Entropyqwe/An-intelligent-following-car-vision-solution-based-on-Orange-Pi-and-STM32/03_接线参考/原图标注修改_单电机_20261029.png

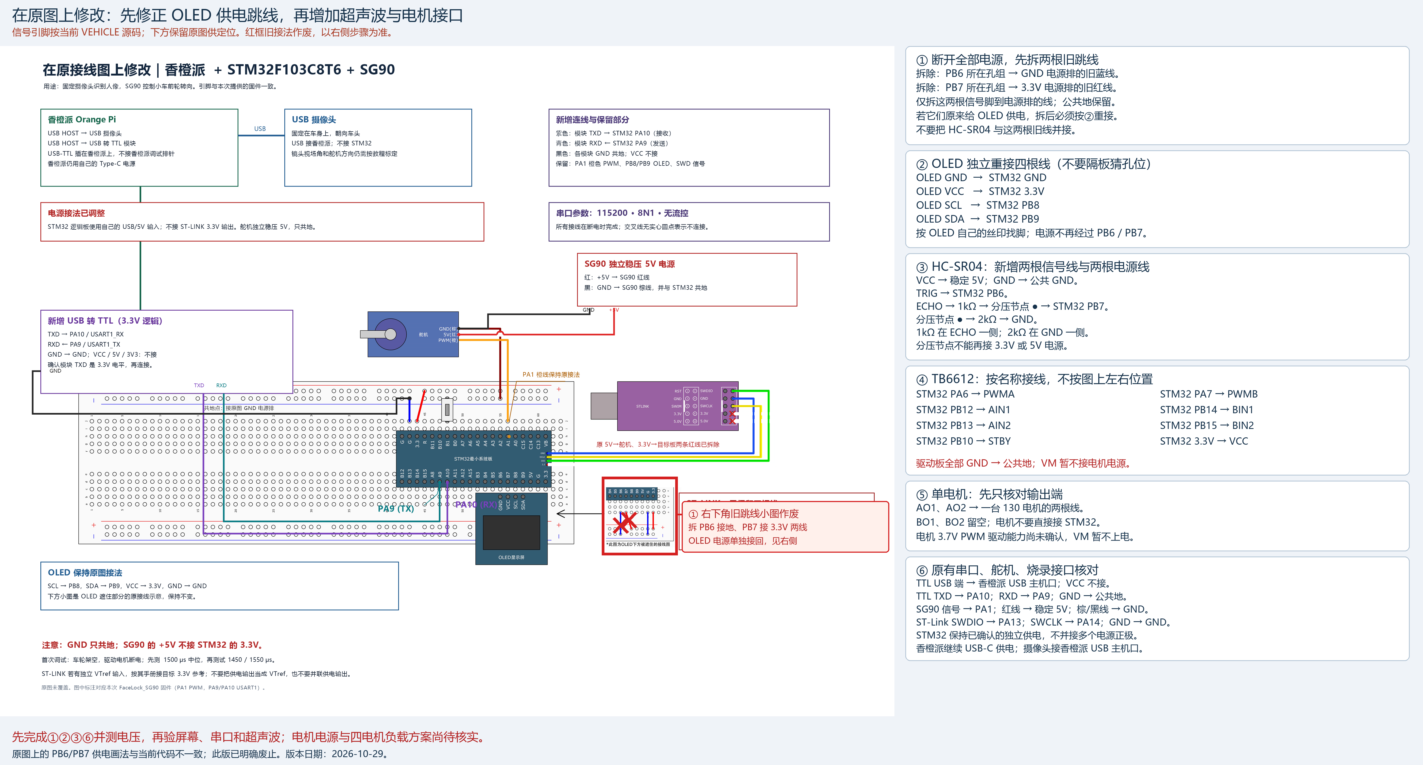
03_接线参考/原图标注修改_单电机_20261029.png
