Entropyqwe/An-intelligent-following-car-vision-solution-based-on-Orange-Pi-and-STM32/03_接线参考/逐线核对_单电机_20261029.png

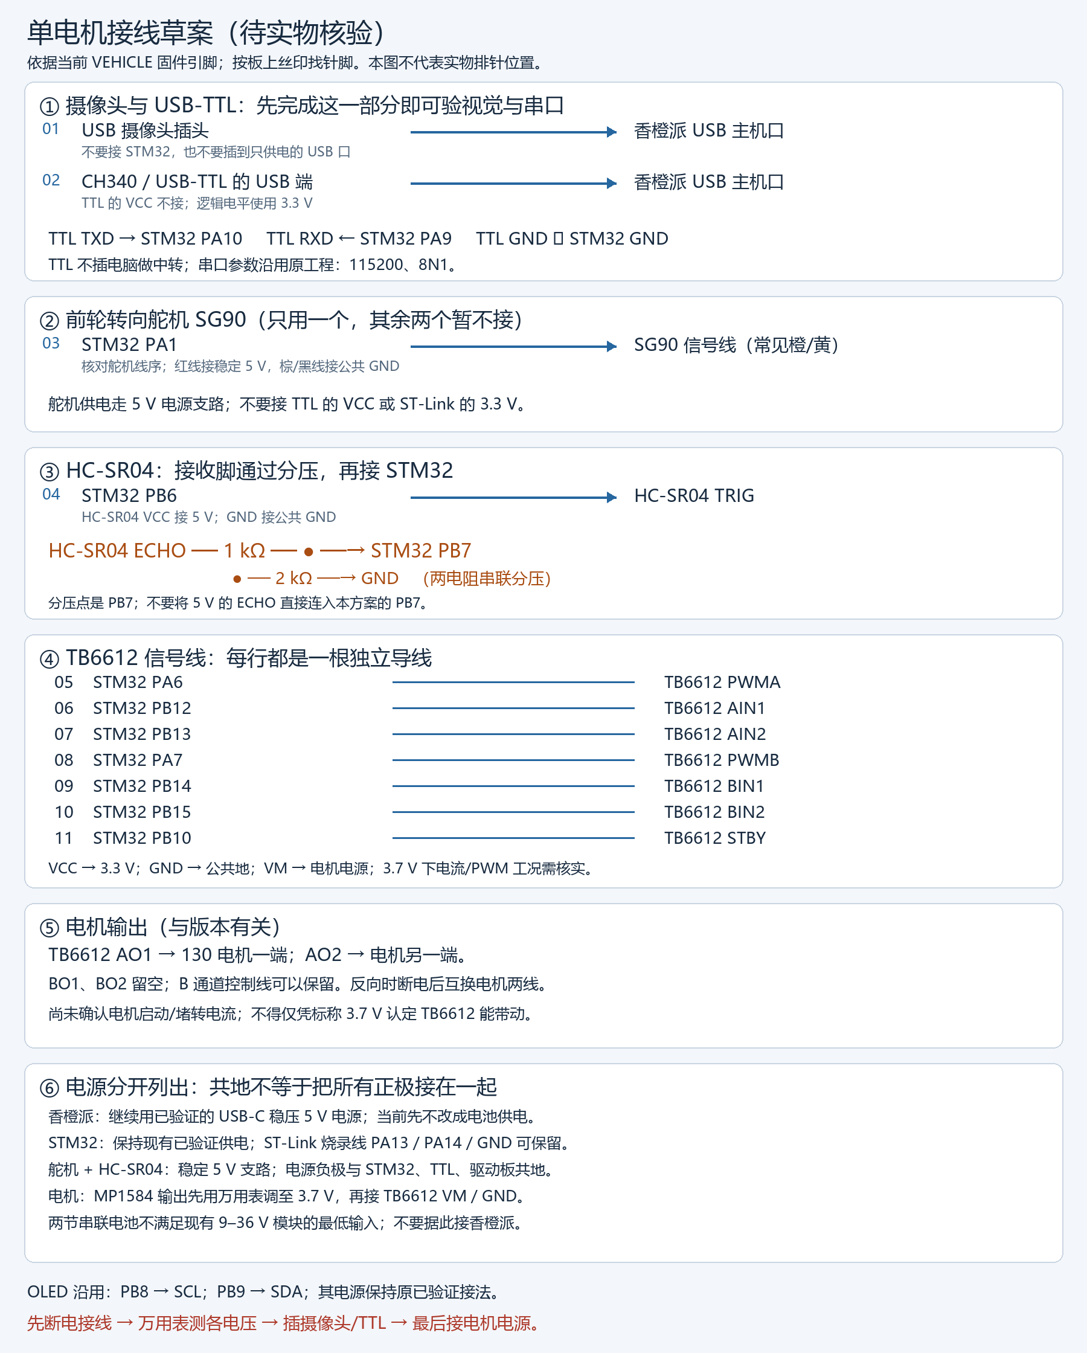
03_接线参考/逐线核对_单电机_20261029.png
