Entropyqwe/An-intelligent-following-car-vision-solution-based-on-Orange-Pi-and-STM32/windows运行/FaceLockCar_Windows/docs/validation_480p/tests_balanced.txt

..................Camera actual resolution: 1280x720; reported FPS: 60.0 (measure actual FPS separately)
........@S1,1,0,0,0,1500,999999,0*7B
@S1,2,1,1,16102,1550,100,2*4A
@S1,3,1,1,16102,1595,200,2*41
@S1,4,0,1,0,1500,999999,0*7F
........
----------------------------------------------------------------------
Ran 34 tests in 0.691s

OK
