Entropyqwe/An-intelligent-following-car-vision-solution-based-on-Orange-Pi-and-STM32/windows运行/FaceLockCar_Windows/docs/NPU_VALIDATION.md

# NPU 升级验证记录

## 2026-10-26后续更新

SSH已经恢复，板端31项测试通过，电脑源代码已同步且保留板端图库与转向配置。TTL实物串口已识别为ttyUSB0；1500/1450/1550µs分别连续回传对应A1，证实MCU接受三档命令，实际轴转角仍需现场观察。此前25FPS窗口无有效目标，仍不算完整跟踪验收。

720p采集及界面已实测。恢复低增益与自动曝光后画面变亮，当前场景摄像头8.33FPS，40秒完整NPU遥测UI预览steady_wall_fps=8.3399，mean_pipeline_ms=41.05，valid_percent=0（画面是墙面）。当前相机输出速度限制帧率，不能声称720p24FPS达成。详见CAMERA_QUALITY.md。下面旧阶段记录保留作为问题经过，不代表网络仍断开。

## 验收边界

目标：完整人像身份核验、人体检测、目标锁定、UI 和原 S1 输出稳定达到 24FPS；30FPS 为优化目标。当前未完成这个组合的最终验收。用户确认新版能够锁定，但随后 SSH 不可达，尚未取得锁定之后的完整日志。未检测到 USB-TTL 时未打开硬件串口，不能以软件回环代替实物舵机验收。

## 已完成

1. 真实板上初始化并执行 VIPLite NPU。驱动版本输出 `2.0.3.2-AW-2024-08-30`，使用系统实际 SDK 头文件编译；未使用猜测 vendor 结构。
2. 网络只初始化/prepare 一次。输出由逐元素拷贝改为映射缓存中的紧凑人体候选，减少 80 类原始头的 Python 拷贝和解码开销。
3. CPU 人脸和 NPU 人体处理同一帧，等待两者完成再进入原跟踪器；没有把旧检测当新检测发送。
4. 原单独编号框已取消，ID 写入头框，界面已在真实 VNC 桌面显示。
5. 新增自动/手动目标选择，并保留原连续确认、冲突和失效处理。
6. 22 项原 Python 测试在板上通过。新增 6 项测试与原测试合计 28 项在电脑完整通过。
7. 原 C 接收解析器/看门狗 5 项测试通过，包括截断/错误校验/范围/10,000 次随机输入/500ms 超时/时间计数回绕。测试编译输出置于独立临时工作目录，未改 MCU 工程。
8. 原 MCU 文件、`core.py`、`body_tracker.py`、`steering.py`、整个 `Output` 类保护哈希检查无差异。

## 实测结果与正确解释

| 场景 | 结果 | 说明 |
| --- | --- | --- |
| 初始 NPU 人体单项，狗图片无人 | 平均约 88.46ms | 包含最初低效输出拷贝 |
| 优化完整输出拷贝后，同一基准 | 约 38.84ms | 不是完整跟踪 FPS |
| 紧凑候选后，同一基准 | 约 31.24ms | 预处理5.68ms，NPU与输出25.56ms，空候选后处理约0.005ms |
| 真实相机流程的人体处理 | 约32～36ms | 已真实运行模型 |
| 真实相机单独采集，明亮画面 | 预热后约33.3FPS | 实际属性返回60，但不能拿60当实际帧率 |
| 有脸、持续身份核验，无窗口 | 多数约20～23FPS | 未稳定24；人脸核验平均约45～53ms |
| 有脸、完整遥测窗口、未有效锁定 | 多数约16～17FPS | CPU核验和显示均有耗时 |
| 核验较少或画面无清晰人脸的窗口 | 约24～25FPS | valid=0%，不能当稳定锁定验收 |
| 稳定锁定 + UI + 真串口 | 待测 | 用户已报告锁定，但 SSH 在读取前失联 |

真实阳性图片上，threshold=0.25 时得到 1 个人体，紧凑解码框约 `(119.999,131.270,321.940,341.401)`、confidence≈0.288529；与完整解码逐项比较通过（坐标误差小于0.001）。这证明正例解码一致，不证明任意光照、姿态下的召回率。主程序默认 threshold=0.45，不能为了帧率数字而静默改变阈值或放宽原身份冲突规则。

SFace 单脸在固定图片上的 CPU 推理约32～36ms，另有 YuNet、对齐和 UI 等开销。不同线程数有波动：2线程人脸全流程约44.6ms、8线程约40.5ms，但实际 GUI 下未证明8线程必然更快。

## 本次调整过的板端状态

- 相机 `exposure_dynamic_framerate`：1 → 0，避免自动曝光主动降低输出率。
- CPU governor：原 `ondemand` → 临时 `performance`；SFace 耗时没有明显改善，不能把此设置宣传成必选加速。
- NPU governor 原本已是 performance / 1008000000Hz，没有超频。
- 未安装开机自动视觉控制服务。
- 未安装新的系统 NPU SDK、未替换驱动、未改原 Python 虚拟环境。

## 后续按顺序补齐

1. 恢复香橙派 SSH，确认 IP、摄像头、实际在运行的新进程与版本。
2. 只同步升级副本的源码和文档；保留板端已新增的图库，不从电脑旧图库覆盖。
3. 重新运行板上28项测试及 `bash install_npu.sh`。
4. 人物正常入镜，自动/手动完成锁定，运行60秒完整UI计时，记录 `steady_wall_fps` 与 `valid_percent`。
5. 若持续核验仍达不到24，进一步优化CPU身份模型运行时，或形成明确的性能/识别召回权衡；任何新运行时先隔离验证，不能悄悄改变身份特征或通信链。
6. 接回原USB-TTL/STM32，先1500/1450/1550µs小幅测试，再真人左右偏移、中心、丢失测试。
7. 完成后更新本报告真实数值，才能将“24FPS目标”改为“通过”。
