Entropyqwe/An-intelligent-following-car-vision-solution-based-on-Orange-Pi-and-STM32/02_STM32/STM32F103_SG90_VEHICLE_HOLD3S/Objects/build_log.txt

D:\ARM\ARMCC\bin\armcc.exe --cpu Cortex-M3 --c99 -O2 --split_sections -DSTM32F10X_MD -DUSE_STDPERIPH_DRIVER -IStart -ILibrary -IUser -IHardware -c E:\FaceLockCar_Project_20261025\src\FaceLockCar_Steering_Integration\STM32F103_SG90_VEHICLE_HOLD3S\User\main.c -o E:\FaceLockCar_Project_20261025\src\FaceLockCar_Steering_Integration\STM32F103_SG90_VEHICLE_HOLD3S\Objects\main.o

D:\ARM\ARMCC\bin\armcc.exe --cpu Cortex-M3 --c99 -O2 --split_sections -DSTM32F10X_MD -DUSE_STDPERIPH_DRIVER -IStart -ILibrary -IUser -IHardware -c E:\FaceLockCar_Project_20261025\src\FaceLockCar_Steering_Integration\STM32F103_SG90_VEHICLE_HOLD3S\User\steering_protocol.c -o E:\FaceLockCar_Project_20261025\src\FaceLockCar_Steering_Integration\STM32F103_SG90_VEHICLE_HOLD3S\Objects\steering_protocol.o

D:\ARM\ARMCC\bin\armcc.exe --cpu Cortex-M3 --c99 -O2 --split_sections -DSTM32F10X_MD -DUSE_STDPERIPH_DRIVER -IStart -ILibrary -IUser -IHardware -c E:\FaceLockCar_Project_20261025\src\FaceLockCar_Steering_Integration\STM32F103_SG90_VEHICLE_HOLD3S\User\vehicle_control.c -o E:\FaceLockCar_Project_20261025\src\FaceLockCar_Steering_Integration\STM32F103_SG90_VEHICLE_HOLD3S\Objects\vehicle_control.o

D:\ARM\ARMCC\bin\armcc.exe --cpu Cortex-M3 --c99 -O2 --split_sections -DSTM32F10X_MD -DUSE_STDPERIPH_DRIVER -IStart -ILibrary -IUser -IHardware -c E:\FaceLockCar_Project_20261025\src\FaceLockCar_Steering_Integration\STM32F103_SG90_VEHICLE_HOLD3S\User\vehicle_hw.c -o E:\FaceLockCar_Project_20261025\src\FaceLockCar_Steering_Integration\STM32F103_SG90_VEHICLE_HOLD3S\Objects\vehicle_hw.o

D:\ARM\ARMCC\bin\armcc.exe --cpu Cortex-M3 --c99 -O2 --split_sections -DSTM32F10X_MD -DUSE_STDPERIPH_DRIVER -IStart -ILibrary -IUser -IHardware -c E:\FaceLockCar_Project_20261025\src\FaceLockCar_Steering_Integration\STM32F103_SG90_VEHICLE_HOLD3S\User\stm32f10x_it.c -o E:\FaceLockCar_Project_20261025\src\FaceLockCar_Steering_Integration\STM32F103_SG90_VEHICLE_HOLD3S\Objects\stm32f10x_it.o

D:\ARM\ARMCC\bin\armcc.exe --cpu Cortex-M3 --c99 -O2 --split_sections -DSTM32F10X_MD -DUSE_STDPERIPH_DRIVER -IStart -ILibrary -IUser -IHardware -c E:\FaceLockCar_Project_20261025\src\FaceLockCar_Steering_Integration\STM32F103_SG90_VEHICLE_HOLD3S\Hardware\OLED.c -o E:\FaceLockCar_Project_20261025\src\FaceLockCar_Steering_Integration\STM32F103_SG90_VEHICLE_HOLD3S\Objects\OLED.o

D:\ARM\ARMCC\bin\armcc.exe --cpu Cortex-M3 --c99 -O2 --split_sections -DSTM32F10X_MD -DUSE_STDPERIPH_DRIVER -IStart -ILibrary -IUser -IHardware -c E:\FaceLockCar_Project_20261025\src\FaceLockCar_Steering_Integration\STM32F103_SG90_VEHICLE_HOLD3S\Start\system_stm32f10x.c -o E:\FaceLockCar_Project_20261025\src\FaceLockCar_Steering_Integration\STM32F103_SG90_VEHICLE_HOLD3S\Objects\system_stm32f10x.o

D:\ARM\ARMCC\bin\armcc.exe --cpu Cortex-M3 --c99 -O2 --split_sections -DSTM32F10X_MD -DUSE_STDPERIPH_DRIVER -IStart -ILibrary -IUser -IHardware -c E:\FaceLockCar_Project_20261025\src\FaceLockCar_Steering_Integration\STM32F103_SG90_VEHICLE_HOLD3S\Library\stm32f10x_rcc.c -o E:\FaceLockCar_Project_20261025\src\FaceLockCar_Steering_Integration\STM32F103_SG90_VEHICLE_HOLD3S\Objects\stm32f10x_rcc.o

D:\ARM\ARMCC\bin\armcc.exe --cpu Cortex-M3 --c99 -O2 --split_sections -DSTM32F10X_MD -DUSE_STDPERIPH_DRIVER -IStart -ILibrary -IUser -IHardware -c E:\FaceLockCar_Project_20261025\src\FaceLockCar_Steering_Integration\STM32F103_SG90_VEHICLE_HOLD3S\Library\stm32f10x_gpio.c -o E:\FaceLockCar_Project_20261025\src\FaceLockCar_Steering_Integration\STM32F103_SG90_VEHICLE_HOLD3S\Objects\stm32f10x_gpio.o

D:\ARM\ARMCC\bin\armcc.exe --cpu Cortex-M3 --c99 -O2 --split_sections -DSTM32F10X_MD -DUSE_STDPERIPH_DRIVER -IStart -ILibrary -IUser -IHardware -c E:\FaceLockCar_Project_20261025\src\FaceLockCar_Steering_Integration\STM32F103_SG90_VEHICLE_HOLD3S\Library\stm32f10x_tim.c -o E:\FaceLockCar_Project_20261025\src\FaceLockCar_Steering_Integration\STM32F103_SG90_VEHICLE_HOLD3S\Objects\stm32f10x_tim.o

D:\ARM\ARMCC\bin\armcc.exe --cpu Cortex-M3 --c99 -O2 --split_sections -DSTM32F10X_MD -DUSE_STDPERIPH_DRIVER -IStart -ILibrary -IUser -IHardware -c E:\FaceLockCar_Project_20261025\src\FaceLockCar_Steering_Integration\STM32F103_SG90_VEHICLE_HOLD3S\Library\stm32f10x_usart.c -o E:\FaceLockCar_Project_20261025\src\FaceLockCar_Steering_Integration\STM32F103_SG90_VEHICLE_HOLD3S\Objects\stm32f10x_usart.o

D:\ARM\ARMCC\bin\armcc.exe --cpu Cortex-M3 --c99 -O2 --split_sections -DSTM32F10X_MD -DUSE_STDPERIPH_DRIVER -IStart -ILibrary -IUser -IHardware -c E:\FaceLockCar_Project_20261025\src\FaceLockCar_Steering_Integration\STM32F103_SG90_VEHICLE_HOLD3S\Library\stm32f10x_iwdg.c -o E:\FaceLockCar_Project_20261025\src\FaceLockCar_Steering_Integration\STM32F103_SG90_VEHICLE_HOLD3S\Objects\stm32f10x_iwdg.o

D:\ARM\ARMCC\bin\armcc.exe --cpu Cortex-M3 --c99 -O2 --split_sections -DSTM32F10X_MD -DUSE_STDPERIPH_DRIVER -IStart -ILibrary -IUser -IHardware -c E:\FaceLockCar_Project_20261025\src\FaceLockCar_Steering_Integration\STM32F103_SG90_VEHICLE_HOLD3S\Library\misc.c -o E:\FaceLockCar_Project_20261025\src\FaceLockCar_Steering_Integration\STM32F103_SG90_VEHICLE_HOLD3S\Objects\misc.o

D:\ARM\ARMCC\bin\armasm.exe --cpu Cortex-M3 E:\FaceLockCar_Project_20261025\src\FaceLockCar_Steering_Integration\STM32F103_SG90_VEHICLE_HOLD3S\Start\startup_stm32f10x_md.s -o E:\FaceLockCar_Project_20261025\src\FaceLockCar_Steering_Integration\STM32F103_SG90_VEHICLE_HOLD3S\Objects\startup.o

D:\ARM\ARMCC\bin\armlink.exe --cpu Cortex-M3 --ro-base 0x08000000 --rw-base 0x20000000 --first startup.o(RESET) --entry Reset_Handler --strict --info sizes --map --list E:\FaceLockCar_Project_20261025\src\FaceLockCar_Steering_Integration\STM32F103_SG90_VEHICLE_HOLD3S\Objects\FaceLock_SG90.map --output E:\FaceLockCar_Project_20261025\src\FaceLockCar_Steering_Integration\STM32F103_SG90_VEHICLE_HOLD3S\Objects\FaceLock_SG90.axf E:\FaceLockCar_Project_20261025\src\FaceLockCar_Steering_Integration\STM32F103_SG90_VEHICLE_HOLD3S\Objects\main.o E:\FaceLockCar_Project_20261025\src\FaceLockCar_Steering_Integration\STM32F103_SG90_VEHICLE_HOLD3S\Objects\steering_protocol.o E:\FaceLockCar_Project_20261025\src\FaceLockCar_Steering_Integration\STM32F103_SG90_VEHICLE_HOLD3S\Objects\vehicle_control.o E:\FaceLockCar_Project_20261025\src\FaceLockCar_Steering_Integration\STM32F103_SG90_VEHICLE_HOLD3S\Objects\vehicle_hw.o E:\FaceLockCar_Project_20261025\src\FaceLockCar_Steering_Integration\STM32F103_SG90_VEHICLE_HOLD3S\Objects\stm32f10x_it.o E:\FaceLockCar_Project_20261025\src\FaceLockCar_Steering_Integration\STM32F103_SG90_VEHICLE_HOLD3S\Objects\OLED.o E:\FaceLockCar_Project_20261025\src\FaceLockCar_Steering_Integration\STM32F103_SG90_VEHICLE_HOLD3S\Objects\system_stm32f10x.o E:\FaceLockCar_Project_20261025\src\FaceLockCar_Steering_Integration\STM32F103_SG90_VEHICLE_HOLD3S\Objects\stm32f10x_rcc.o E:\FaceLockCar_Project_20261025\src\FaceLockCar_Steering_Integration\STM32F103_SG90_VEHICLE_HOLD3S\Objects\stm32f10x_gpio.o E:\FaceLockCar_Project_20261025\src\FaceLockCar_Steering_Integration\STM32F103_SG90_VEHICLE_HOLD3S\Objects\stm32f10x_tim.o E:\FaceLockCar_Project_20261025\src\FaceLockCar_Steering_Integration\STM32F103_SG90_VEHICLE_HOLD3S\Objects\stm32f10x_usart.o E:\FaceLockCar_Project_20261025\src\FaceLockCar_Steering_Integration\STM32F103_SG90_VEHICLE_HOLD3S\Objects\stm32f10x_iwdg.o E:\FaceLockCar_Project_20261025\src\FaceLockCar_Steering_Integration\STM32F103_SG90_VEHICLE_HOLD3S\Objects\misc.o E:\FaceLockCar_Project_20261025\src\FaceLockCar_Steering_Integration\STM32F103_SG90_VEHICLE_HOLD3S\Objects\startup.o

D:\ARM\ARMCC\bin\fromelf.exe --i32combined --output E:\FaceLockCar_Project_20261025\src\FaceLockCar_Steering_Integration\STM32F103_SG90_VEHICLE_HOLD3S\Objects\FaceLock_SG90.hex E:\FaceLockCar_Project_20261025\src\FaceLockCar_Steering_Integration\STM32F103_SG90_VEHICLE_HOLD3S\Objects\FaceLock_SG90.axf

D:\ARM\ARMCC\bin\fromelf.exe --bin --output E:\FaceLockCar_Project_20261025\src\FaceLockCar_Steering_Integration\STM32F103_SG90_VEHICLE_HOLD3S\Objects\FaceLock_SG90.bin E:\FaceLockCar_Project_20261025\src\FaceLockCar_Steering_Integration\STM32F103_SG90_VEHICLE_HOLD3S\Objects\FaceLock_SG90.axf
