Entropyqwe/An-intelligent-following-car-vision-solution-based-on-Orange-Pi-and-STM32/02_STM32/STM32F103_SG90_VEHICLE_HOLD3S/STM32F103_SG90_VEHICLE_HOLD3S_PinView.ioc

Mcu.UserName=STM32F103C8Tx
PA1.Signal=S_TIM2_CH2
PA6.Signal=S_TIM3_CH1
PA7.Signal=S_TIM3_CH2
PA9.Signal=USART1_TX
PA10.Signal=USART1_RX
PB6.Signal=GPIO_Output
PB7.Signal=GPIO_Input
PB8.Signal=GPIO_Output
PB9.Signal=GPIO_Output
PB10.Signal=GPIO_Output
PB12.Signal=GPIO_Output
PB13.Signal=GPIO_Output
PB14.Signal=GPIO_Output
PB15.Signal=GPIO_Output
PA13.Signal=SYS_JTMS-SWDIO
PA14.Signal=SYS_JTCK-SWCLK
PD0-OSC_IN.Signal=RCC_OSC_IN
PD1-OSC_OUT.Signal=RCC_OSC_OUT
